jduffy105/HydraMeter_L_DesignReview_0.1.1/PDF_and_Images/PCB_Bottom.PNG

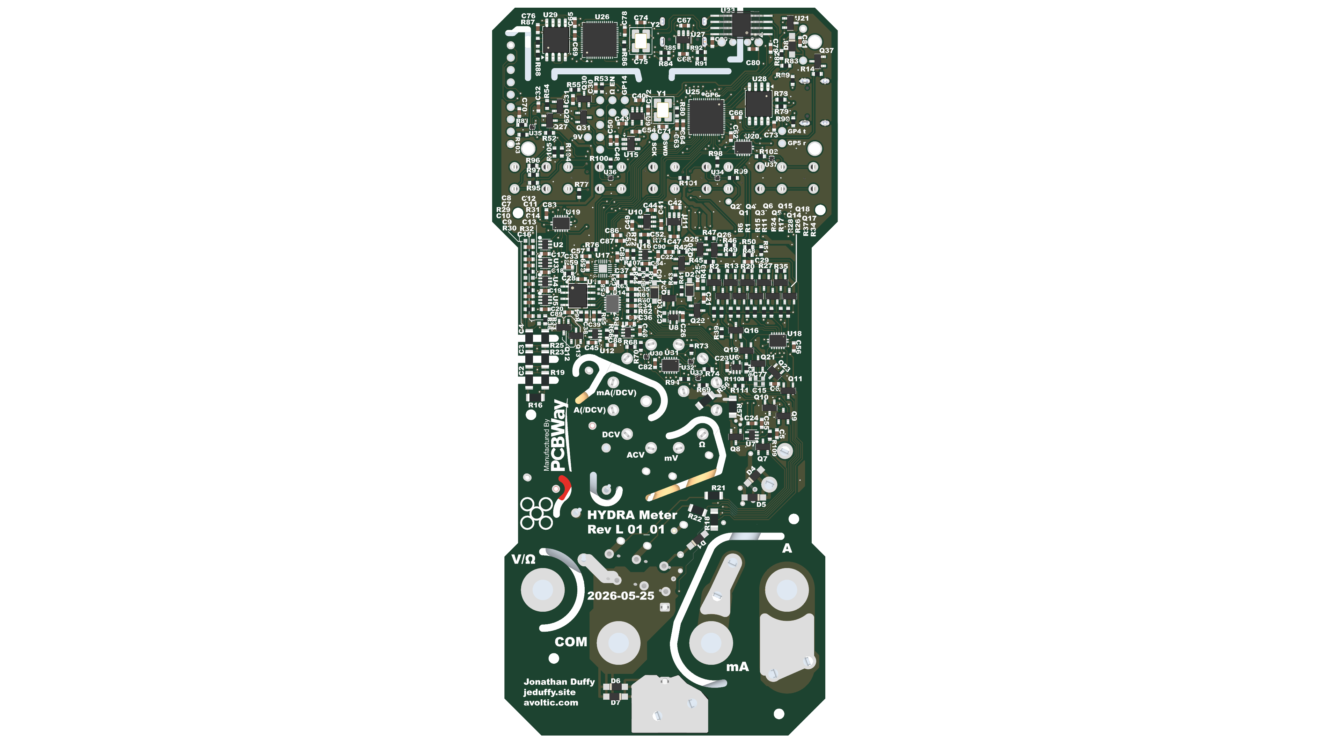
PDF_and_Images/PCB_Bottom.PNG
