jduffy105/HydraMeter_L_DesignReview_0.1.1/Production_Files/2026-05-25-00-31-10/Customer_Update_T-1D27W43482A-12units-LCMTR_0101_BOM_ul_26_05_25_0014.xls

PCBWay Bom Quotation, Product No.:T-1D27W43482A
Item # | *Designator | *Qty | Manufacturer | *Mfg Part # | Description / Value | Vendor Part # | *Package/Footprint | Your Instructions / Notes | *Unit Price(12 units) | *Total | *Delivery Time | *Actual Purchase Mfg Part # | *PCBWay Note | Customer Reply | PCBWay Update
1 | C2,C3,C4 | 3 | muRata | GRM31A5C3A331JWA1D | 330p | Digikey『 』490-GRM31A5C3A331JWA1DCT-ND『 』https://www.digikey.com/en/products/detail/murata-electronics/GRM31A5C3A331JWA1D/10692922 | 1206 |  | $0.171 | $6.156
2 | C5,C14,C43,C44 | 4 | YAGEO | CC0603FRNPO9BN101 | 100p | LCSC『 』C513648『 』https://www.lcsc.com/product-detail/C513648.html | 0603 |  | $0.019 | $0.912
3 | C6,C10,C13,C85,C86,C87,C88,C95 | 8 | YAGEO | CC0603FRNPO9BN102 | 1n | LCSC『 』C309468『 』https://www.lcsc.com/product-detail/C309468.html | 0603 |  | $0.024 | $2.304
4 | C7 | 1 | KEMET | C0603C333J8JACAUTO | 33n | LCSC『 』C3896683『』https://www.lcsc.com/product-detail/C3896683.html | 0603 |  | $0.200 | $2.394 |  |  | The correct capacitance value for the listed Part Number [GRM1887U1A303JA01J] is indeed [30nF], not [33nF].Please confirm. | My mistake - replaced with new part # - C0603C333J8JACAUTO, which should be 33n
5 | C9,C21,C33,C34,C35,C36,C37,C38,C39,C81 | 10 | YAGEO | CC0603JRNPO9BN103 | 10n | LCSC『 』C389113『 』https://www.lcsc.com/product-detail/C389113.html | 0603 |  | $0.032 | $3.840
6 | C11 | 1 | muRata | GRM1885C1H332JA01D | 3.3n | LCSC『 』C77036『 』https://www.lcsc.com/product-detail/C77036.html | 0603 |  | $0.084 | $1.008
7 | C16 | 1 | YAGEO | CC0603JRNPO9BN331 | 330p | LCSC『 』C62784『 』https://www.lcsc.com/product-detail/C62784.html | 0603 |  | $0.048 | $0.576
8 | C17,C18,C19,C20,C23,C24,C25,C45,C46,C52,C53,C55 | 12 | Samsung | CL10B104KB8NNNC | 100n | LCSC『 』C1591『 』https://www.lcsc.com/product-detail/C1591.html | 0603 | Equivalent subsitiutions allowed if approved by customer | $0.007 | $1.008
9 | C22,C26,C28,C29,C30,C31,C32,C40,C41,C42,C47,C48,C49,C50,C51,C54,C56,C57,C58,C59,C60,C62,C63,C64,C65,C66,C67,C68,C69,C70,C73,C76,C78,C79,C80,C82,C83,C84,C89,C90,C91 | 41 | Samsung | CL10B105KB8NQNC | 1u | LCSC『 』C5199872『 』https://www.lcsc.com/product-detail/C5199872.html&spm=wm.fly.bg.9.xh___wm.fly.tp.4.ml | 0603 | Equivalent subsitiutions allowed if approved by customer | $0.011 | $5.412
10 | C71,C72,C74,C75 | 4 | Samsung | CL10C150JB8NNNC | 15p | LCSC『 』CL10C150JB8NNNC『 』https://www.lcsc.com/product-detail/C1644.html | 0603 |  | $0.016 | $0.768
11 | D1,D4,D5,D6,D7,D8 | 6 | SMC | 1N4007FL | 1N4007FL | LCSC『 』C493190『 』https://www.lcsc.com/product-detail/C493190.html | 1N4007FL |  | $0.155 | $11.160 | 7-10 Workdays
12 | D2 | 1 | VISHAY | MMSZ4691-E3-08 | 6.1V | Digikey『 』MMSZ4691-E3-08GICT-ND『 』https://www.digikey.com/en/products/detail/vishay-general-semiconductor-diodes-division/MMSZ4691-E3-08/4832264 | SOD123_MMSZ5231B-7-F |  | $0.509 | $6.108 | 7-10 Workdays
13 | D3 | 1 | Diodes Inc | MMSZ5232B-7-F | 5.6V | LCSC『 』C156265『 』https://www.lcsc.com/product-detail/C156265.html | SOD123_MMSZ5231B-7-F |  | $0.047 | $0.564
14 | Q1,Q3,Q5,Q7,Q8,Q9,Q10,Q12,Q13,Q14,Q17,Q20,Q26,Q30,Q37 | 15 | onsemi | MMBT3904LT1G |  | LCSC『 』C81464『 』https://www.lcsc.com/product-detail/C81464.html | SOT23-3 |  | $0.021 | $3.780
15 | Q2,Q4,Q6,Q11,Q15,Q18,Q22,Q24,Q25,Q27,Q29,Q31 | 12 | Diotec | MMFTP84 |  | Digikey『 』4878-MMFTP84CT-ND『 』https://www.digikey.com/en/products/detail/diotec-semiconductor/MMFTP84/13154778 | DMN65D8L-7 |  | $0.129 | $18.576 | 7-10 Workdays
16 | Q16,Q19,Q21,Q23 | 4 | Infineon | IRLML6344TRPBF |  | LCSC『 』C53550『 』https://www.lcsc.com/product-detail/C53550.html | DMN65D8L-7 |  | $0.189 | $9.072
17 | R1,R11,R17,R26,R34,R39,R45,R49,R50,R52,R53,R71,R72,R95,R96,R97 | 16 | YAGEO | RC0603FR-07100KL | 100K | LCSC『 』C14675『 』https://www.lcsc.com/product-detail/C14675.html | 0603 | Equivalent subsitiutions allowed if approved by customer | $0.002 | $0.384
18 | R2,R13,R20,R27,R35,R36,R47,R54,R68,R69,R70,R73,R74 | 13 | YAGEO | RT0603FRE07330KL | 330K | LCSC『 』C863745『 』https://www.lcsc.com/product-detail/C863745.html | 0603 | Equivalent subsitiutions allowed if approved by customer | $0.023 | $3.588
19 | R14,R33,R42,R55,R80,R83,R86,R88,R109,R110,R111 | 11 | YAGEO | RC0603FR-071KL | 1K | LCSC『 』C22548『 』https://www.lcsc.com/product-detail/C22548.html | 0603 | Equivalent subsitiutions allowed if approved by customer | $0.003 | $0.396
20 | R16 | 1 | Bourns | CHV1206-FX-1003ELF | 100K | LCSC『 』C2078737『 』https://www.lcsc.com/product-detail/C2078737.html | 1206 |  | $0.364 | $4.368
21 | R18 | 1 | YAGEO | SR1206JR-7W470RL |  | LCSC『 』C874087『 』https://www.lcsc.com/product-detail/C874087.html | 1206 |  | $0.089 | $1.068
22 | R21,R22 | 2 | YAGEO | AH1206FR-071ML | 1M | LCSC『 』C43749042『 』https://www.lcsc.com/product-detail/C43749042.html | 1206 |  | $0.092 | $2.208
23 | R41,R48,R66,R67,R76,R77,R82,R87 | 8 | YAGEO | RC0603FR-0710KL | 10K | LCSC『 』C98220『 』https://www.lcsc.com/product-detail/C98220.html | 0603 | Equivalent subsitiutions allowed if approved by customer | $0.002 | $0.192
24 | R43,R44 | 2 | Vishay | MCT06030D3301BP500 | 3.3K | LCSC『 』C1700477『 』https://www.lcsc.com/product-detail/C1700477.html | 0603 |  | $0.240 | $5.760
25 | R46,R51,R94,R98,R99,R100,R101,R102 | 8 | Vishay | CRCW060333K0FKEA | 33K | LCSC『 』C844778『 』https://www.lcsc.com/product-detail/C844778.html | 0603 | Equivalent subsitiutions allowed if approved by customer | $0.011 | $1.056
26 | R59,R60,R61,R62,R63,R64,R65,R106,R107 | 9 | Panasonic | ERJ3EKF2200V |  | LCSC『 』C403073『 』https://www.lcsc.com/product-detail/C403073.html | 0603 | Equivalent subsitiutions allowed if approved by customer | $0.013 | $1.404
27 | R75,R78,R79,R81,R84,R85,R103,R104,R105 | 9 | Vishay | CRCW060327R0FKEA |  | LCSC『 』C844545『 』https://www.lcsc.com/product-detail/C844545.html | 0603 |  | $0.014 | $1.512
28 | R89,R90,R91,R92 | 4 | YAGEO | AC0603FR-075K1L | 5.1K | LCSC『 』C125891『 』https://www.lcsc.com/product-detail/C125891.html | 0603 | Equivalent subsitiutions allowed if approved by customer | $0.007 | $0.336
29 | U1 | 1 | Diodes Inc | AS2376QS-13 | 0.2pA 5uV | LCSC『 』C19948478『 』https://www.lcsc.com/product-detail/C19948478.html | SOIC-8_AS2376S-13 |  | $0.673 | $8.076 | 7-10 Workdays
30 | U2,U3,U4,U5 | 4 | Texas Instruments | TS5A3159DCKR | TS5A3159DCKR | LCSC『 』C46388『 』https://www.lcsc.com/product-detail/C46388.html | SC-70_TS5A3159DCKR |  | $0.289 | $13.872
31 | U6,U7,U8,U12,U13,U16 | 6 | Texas Instruments | TLV333IDCKR | TLV333IDCKR | LCSC『 』C181502『 』https://www.lcsc.com/product-detail/C181502.html | SC-70-5_AS333SE-7 |  | $0.280 | $20.160
32 | U9,U10 | 2 | Diodes Inc | AP2210K-5.0TRG1 | 5V | LCSC『 』C500758『 』https://www.lcsc.com/product-detail/C500758.html | SOT23-5 |  | $0.218 | $5.232
33 | U11,U15,U27 | 3 | Toshiba | TCR2EF33,LM(CT | 3.3V | LCSC『 』C843273『 』https://www.lcsc.com/product-detail/C843273.html | SC-74A_standard |  | $0.106 | $3.816
34 | U14 | 1 | Nexperia | NMUX1308BQX | NMUX1308 | Digikey『 』1727-NMUX1308BQXCT-ND『 』https://www.digikey.com/en/products/detail/nexperia-usa-inc/NMUX1308BQX/22050149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 | 16-DHVQFN_NMUX1308 |  | $0.382 | $4.584 | 7-10 Workdays
35 | U17 | 1 | Microchip | MCP3561RT-E/NC | MCP3561RT | Digikey『 』150-MCP3561RT-E/NCCT-ND『 』https://www.digikey.com/en/products/detail/microchip-technology/MCP3561RT-E-NC/12807389 | MCP3460R_VQFN-20_3x3mm_EP |  | $4.689 | $56.268 | 7-10 Workdays
36 | U18,U19,U20,U31 | 4 | Nexperia | 74HC595BQ,115 | 74HC595BQ,115 | LCSC『 』C730243『 』https://www.lcsc.com/product-detail/C730243.html | 16-DHVQFN_74HC595BQ |  | $0.262 | $12.576
37 | U21 | 1 | Microchip | 11AA160T-I/TT | 16Kbit | Digikey『 』11AA160T-I/TTCT-ND『 』https://www.digikey.com/en/products/detail/microchip-technology/11AA160T-I-TT/1851330 | SOT23-3 |  | $0.613 | $7.356 | 7-10 Workdays
38 | U23 | 1 | Texas Instruments | ISO6721FQDWVRQ1 | ISO6721FQDWVRQ1 | LCSC『 』C5216428『 』https://www.lcsc.com/product-detail/C5216428.html | SOIC-8_STISO621TR |  | $1.090 | $13.080
39 | U25,U26 | 2 | Raspberry Pi | RP2040 | RP2040 | LCSC『 』C2040『 』https://www.lcsc.com/product-detail/C2040.html | QFN-56-1EP_7x7mm_P0.4mm_EP3.2x3.2mm |  | $1.308 | $31.392
40 | U28,U29 | 2 | Winbond | W25Q16JVSS | W25Q16JVSS | LCSC『 』C82317『 』https://www.lcsc.com/product-detail/C82317.html | SOIC-8_5.3x5.3mm_P1.27mm |  | $0.981 | $23.544 |  | W25Q16JVSSIQ |  | Customer Accepts
41 | U30,U32,U33,U34,U35,U36,U37 | 7 | onsemi | NST3904DP6T5G | NST3904DP6T5G | LCSC『 』C462939『 』https://www.lcsc.com/product-detail/C462939.html | SOT-963_NST3904DP6T5G |  | $0.065 | $5.460
42 | Y1,Y2 | 2 | Abracon | ABM8-272-T3 | ABM8-272-T3 | LCSC『 』C20625731『 』https://www.lcsc.com/product-detail/C20625731.html | XTAL_3225-4Pin_3.2x2.5mm |  | $0.480 | $11.520
 |  |  |  |  |  |  |  |  | Component Cost | $312.85
 |  |  |  |  |  |  |  |  | Assembly Cost
 |  |  |  |  |  |  |  |  | PCB Cost
 |  |  |  |  |  |  |  |  | V2 Member 2% off | -$0.00
 |  |  |  |  |  |  |  |  | All Total 12 Units | $312.85
