jduffy105/HydraMeter_L_DesignReview_0.1.1/PDF_and_Images/LCMTR_01_01-User_Comments.pdf

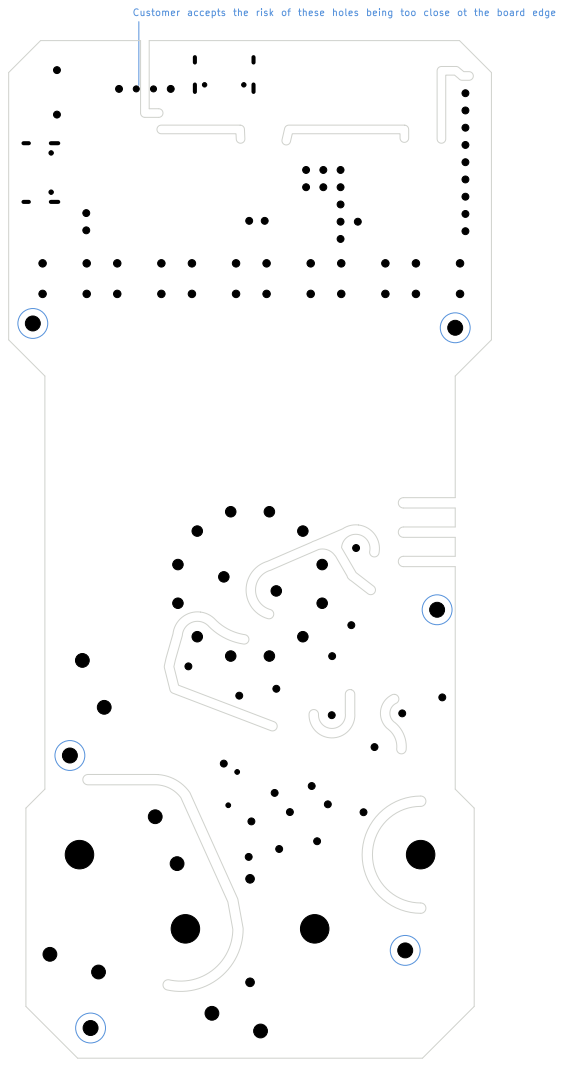
[picture p2: page 1]

Customer accepts the risk of these holes being too close ot the board edge
