jduffy105/HydraMeter_L_DesignReview_0.1.1/PDF_and_Images/sch.pdf

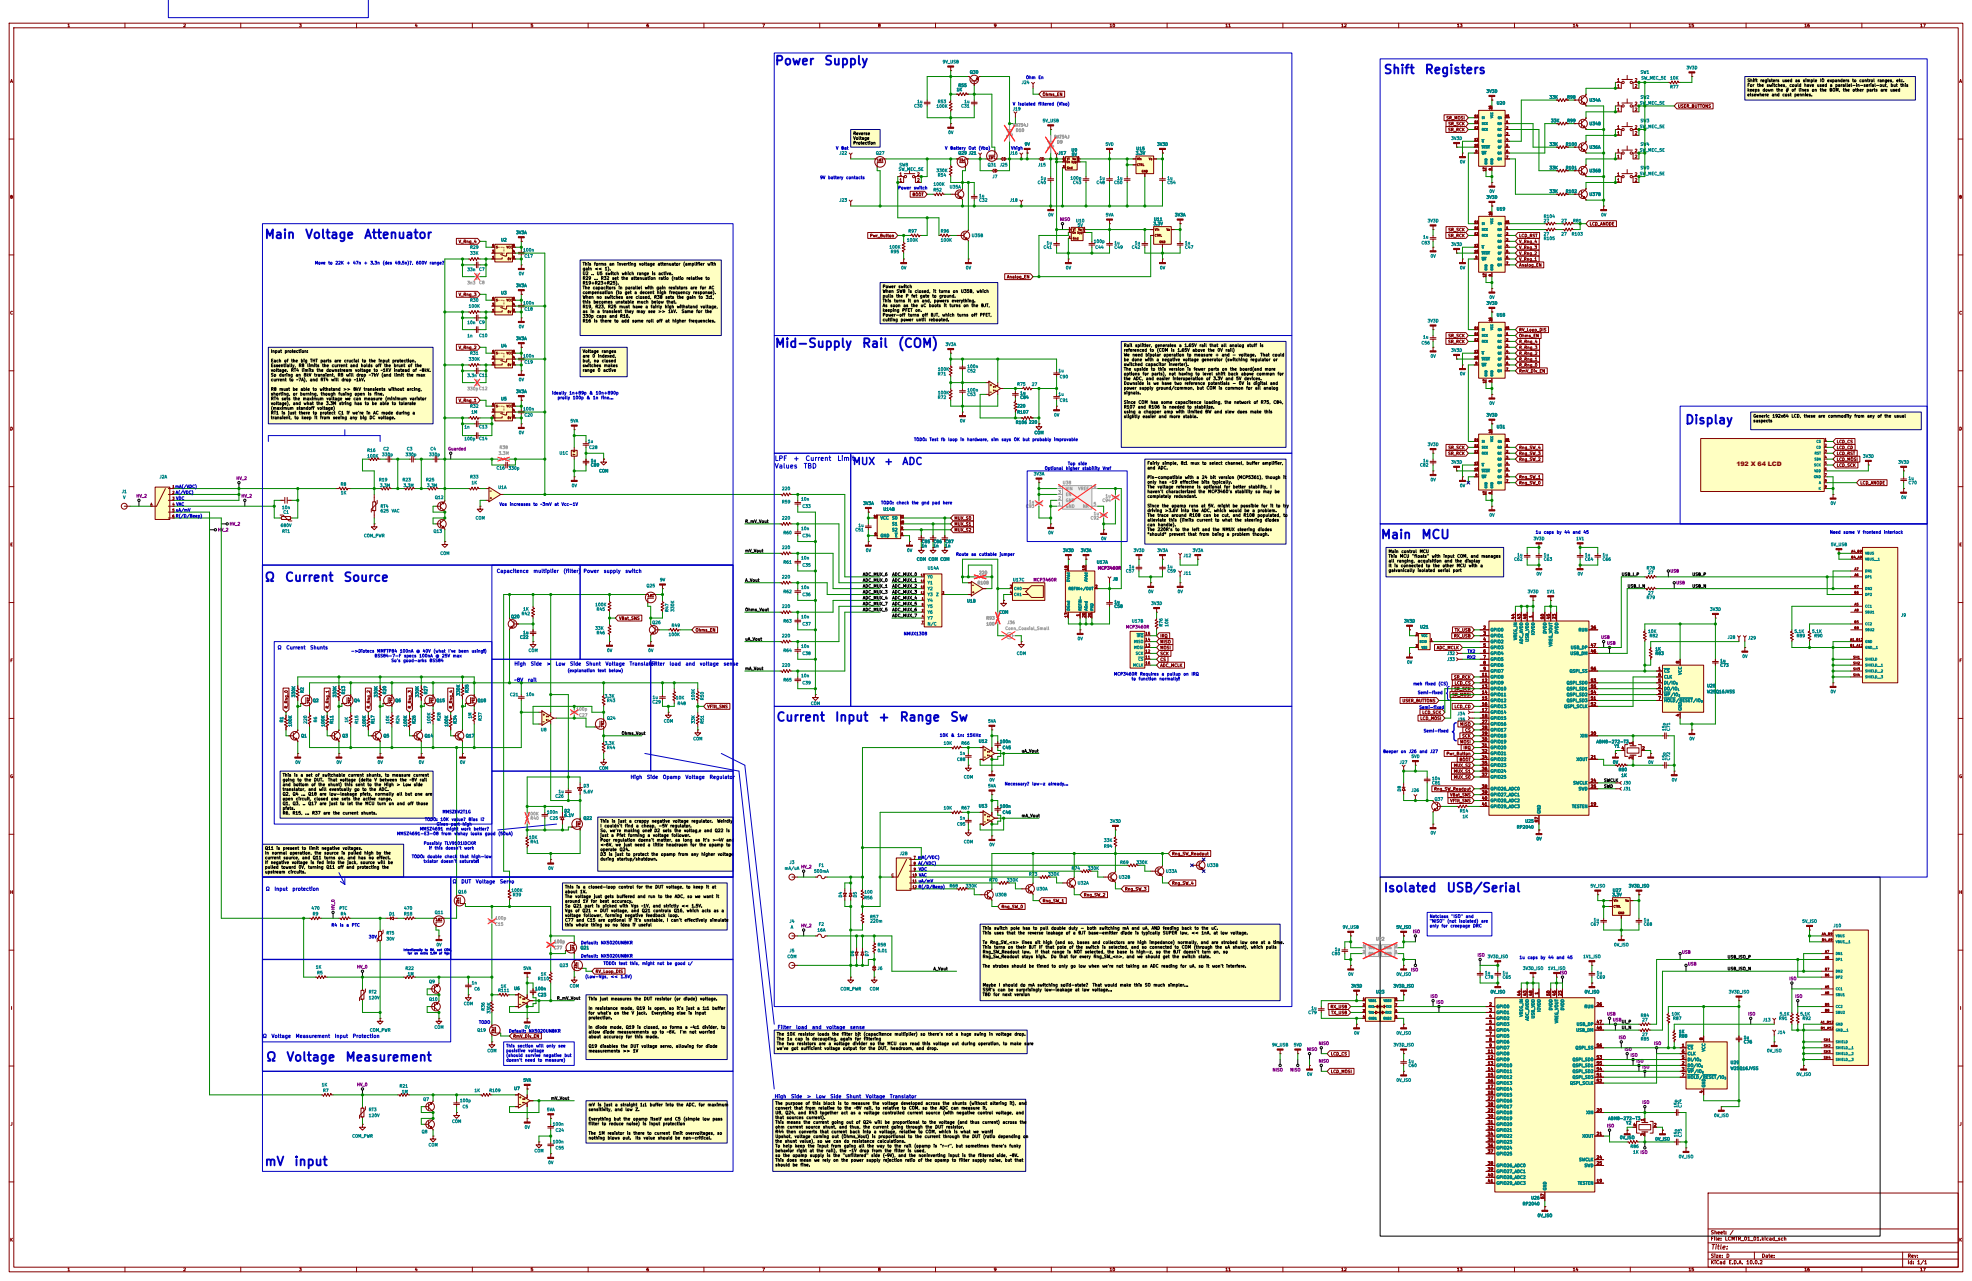
[picture p3: page 1]

V isolated filtered (Viso) 9V battery contacts Power Supply

Need some V frontend interlock Shift Registers

Shift registers used as simple IO expanders to control ranges, etc. For the switches, could have used a parallel-in-serial-out, but this

keeps down the # of lines on the BOM, the other parts are used

elsewhere and cost pennies. Rail splitter, generates a 1.65V rail that all analog stuff is

Generic 192x64 LCD, these are commodity from any of the usual suspects Move to 22K + 47n + 3.3n (des 49.5n)?, 600V range?

This forms an inverting voltage attenuator (amplifier with
gain << 1). U2 .. U5 switch which range is active. R29 ... R32 set the attenuation ratio (ratio relative to R19+R23+R25). The capacitors in parallel with gain resistors are for AC

VAC Mid-Supply Rail (COM)

compensation (to get a decent high frequency response). When no switches are closed, R38 sets the gain to 3:1, this becomes unstable much below that. R19, R23, R25 must have a fairly high withstand voltage, as in a transient they may see >> 1kV. Same for the 330p caps and R16. R16 is there to add some roll off at higher frequencies.

pulls the P fet gate to ground. This turns it on and, powers everything. As soon as the uC boots it turns on the BJT,

keeping PFET on. Power-off turns off BJT, which turns off PFET,

cutting power until rebooted.

Input protection: Each of the big THT parts are crucial to the input protection.

Voltage ranges are 0 indexed,

referenced to (COM is 1.65V above the 0V rail) We need bipolar operation to measure + and - voltage. That could

be done with a negative voltage generator (switching regulator or switched capacitor inverter). The upside to this version is fewer parts on the board(and more options for parts), not having to level shift back above common for

Essentially, R8 limits the current and holds off the brunt of the
voltage. RT4 limits the downstream voltage to ~1KV instead of ~8kV. So during an 8kV transient, R8 will drop ~7kV (and limit the max current to ~7A), and RT4 will drop ~1kV. R8 must be able to withstand >> 8kV transients without arcing,

TODO: Test fb loop in hardware, sim says OK but probably improvable Route as cuttable jumper 10K & 1n: 15KHz uA/mV

the ADC, and easier interoperation of 3.3V and 5V devices. Downside is we have two reference potentials - 0V is digital and

power supply ground/common, but COM is common for all analog
signals. Since COM has some capacitence loading, the network of R75, C84, R107 and R106 is needed to stabilize. using a chopper amp with limited BW and slew does make this

shorting, or burning, though fusing open is fine. RT4 sets the maximum voltage we can measure (minimum varistor voltage), and what the 3.3M string has to be able to tolerate

(maximum standoff voltage) RT1 is just there to protect C1 if we're in AC mode during a

slightly easier and more stable.

transient, to keep it from seeing any big DC voltage.

Top side Optional higher stability Vref

Fairly simple, 8:1 mux to select channel, buffer amplifier, and ADC. Pin-compatible with a 24 bit version (MCP5361), though it only has ~19 effective bits typically. The voltage referene is optional for better stability, I haven't characterized the MCP3460's stability so may be

completely redundant. Since the opamp runs at 5V, might be possible for it to try

TODO: check the gnd pad here
11 VCC

driving >3.6V into the ADC, which would be a problem. The trace around R108 can be cut, and R108 populated, to

alleviate this (limits current to what the steering diodes can handle). The 220R's to the left and the NMUX steering diodes

*should* prevent that from being a problem though.

This MCU "floats" with input COM, and manages all ranging, acquisition and the display

1 REFIN+/OUT 2 DGnd 17 DVdd 18 AVdd 19 AGnd 20 PAD 21 U17A MCP3460R

1 REFIN+/OUT 2 DGnd 17 DVdd 18 AVdd 19 AGnd 20 PAD 21

It is connected to the other MCU with a
galvanically isolated serial port

Power supply switch Ω Current Source

Filter load and voltage sense

Current Input + Range Sw

Semi-fixed meh fixed (CS) Semi-fixed

Beeper on J26 and J27 High Side > Low Side Shunt Voltage Translator

This is a set of switchable current shunts, to measure current going to the DUT. That voltage (delta V between the ~8V rail and bottom of the shunt) this sent to the High > Low side

translator, and will eventually go to the ADC. Q2, Q4 ... Q18 are low-leakage pfets, normally all but one are open circuit, closed one sets the active range. Q1, Q3, .. Q17 are just to let the MCU turn on and off those pfets.

R6, R15, ... R37 are the current shunts. Q11 is present to limit negative voltages.

This is just a crappy negative voltage regulator. Weirdly
I couldn't find a cheap, -5V regulator.
So, we're making one! D2 sets the voltag,e and Q22 is
just a Pfet forming a voltage follower. Poor regulation doens't matter, as long as it's >~4V and <~6V, we just need a little headroom for the opamp to

Possibly TLV9101IDCKR
if this doesn't work

In normal operation, the source is pulled high by the
current source, and Q11 turns on, and has no effect.
If negative voltage is fed into the jack, source will be pulled toward 0V, turning Q11 off and protecting the upstream circuits.

operate Q24. D3 is just to protect the opamp from any higher voltage

10 | R73 | 330K

This is a closed-loop control for the DUT voltage, to keep it at about 1V. The voltage just gets buffered and run to the ADC, so we want it around 1V for best accuracy. So Q21 part is picked with Vgs ~1V, and strictly << 1.5V. Vgs of Q21 = DUT voltage, and Q21 controls Q16, which acts as a

1u caps by 44 and 45 Isolated USB/Serial

voltage follower, forming negative feedback loop. C77 and C15 are optional if it's unstable, I can't effectively simulate

"NISO" (not isolated) are only for creepage DRC

Intentionally to 0V, not COM,

Rng_SW_Readout low. If that range is NOT selected, the base is high-z, so the BJT doesn't turn on, so Rng_Sw_Readout stays high. Do that for every Rng_SW_<n>, and we should get the switch state. The strobes should be timed to only go low when we're not taking an ADC reading for uA, so it won't interfere. Maybe I should do mA switching solid-state? That would make this SO much simpler... SSR's can be surprisingly low-leakage at low voltage... TBD for next version

TODO: test this, might not be good :/
RV_Loop_DIS

This just measures the DUT resistor (or diode) voltage.

In resistance mode, Q19 is open, so it's just a 1:1 buffer
for what's on the V jack. Everything else is input
protection.

In diode mode, Q19 is closed, so forms a ~4:1 divider, to
allow diode measurements up to ~6V. I'm not worried
about accuracy for this mode. Q19 disables the DUT voltage servo, allowing for diode measurements >> 1V

Ω Voltage Measurement Input Protection
Ω Voltage Measurement

The 10K resistor loads the filter bjt (capacitence multiplier) so there's not a huge swing in voltage drop. The 1u cap is decoupling, again for filtering

The two resistors are a voltage divider so the MCU can read this voltage out during operation, to make sure we've got sufficient voltage output for the DUT, headroom, and drop.

This section will only see posistive voltage

The purpose of this block is to measure the voltage developed across the shunts (without altering it), and
convert that from relative to the ~8V rail, to relative to COM, so the ADC can measure it. U8, Q24, and R43 together act as a voltage controlled current source (with negative control voltage, and

mV is just a straight 1:1 buffer into the ADC, for maximum
sensitivity, and low Z. Everything but the opamp itself and C5 (simple low pass

filter to reduce noise) is input protection

that sources current). This means the current going out of Q24 will be proportional to the voltage (and thus current) across the ohm current source shunt, and thus, the current going through the DUT resistor. R44 then converts that current back into a voltage, relative to COM, which is what we want! Upshot, voltage coming out (Ohms_Vout) is proportional to the current through the DUT (ratio depending on

The 1M resistor is there to current limit overvoltages, so
nothing blows out. Its value should be non-critical.

the shunt value), so we can do resistance calculations. To help keep the input from going all the way to the rail (opamp is "r-r", but sometimes there's funky behavior right at the rail), the ~1V drop from the filter is used, so the opamp supply is the "unfiltered" side (~9V), and the noninverting input is the filtered side, ~8V. This does mean we rely on the power supply rejection ratio of the opamp to filter supply noise, but that should be fine.

Size: D | Rev:
KiCad E.D.A. 10.0.2 | Id: 1/1
