jduffy105/HydraMeter_L_DesignReview_0.1.1/PDF_and_Images/LCMTR_01_01-B_Cu.pdf

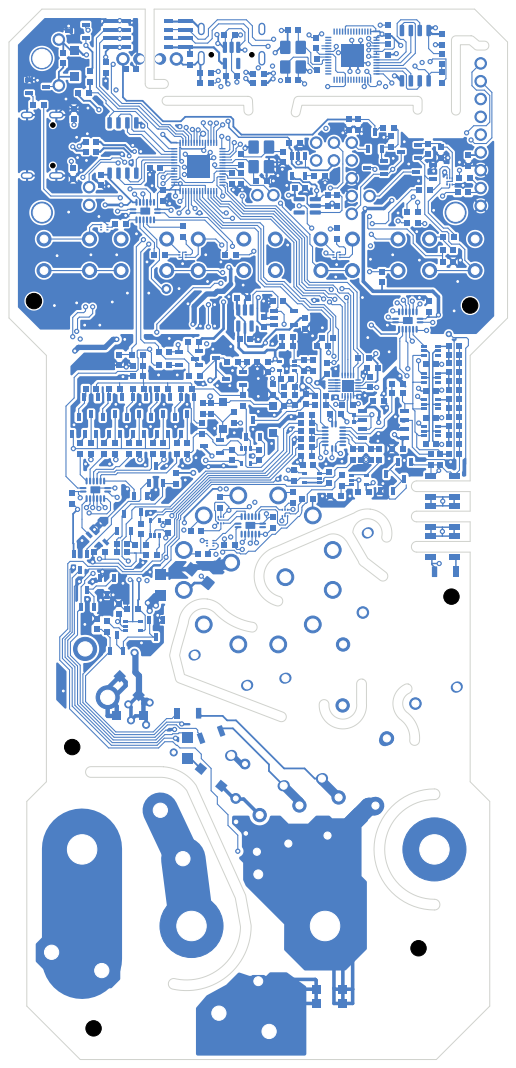
[picture p4: page 1]
