jduffy105/HydraMeter_L_DesignReview_0.1.1/PDF_and_Images/LCMTR_01_01-F_Cu.pdf

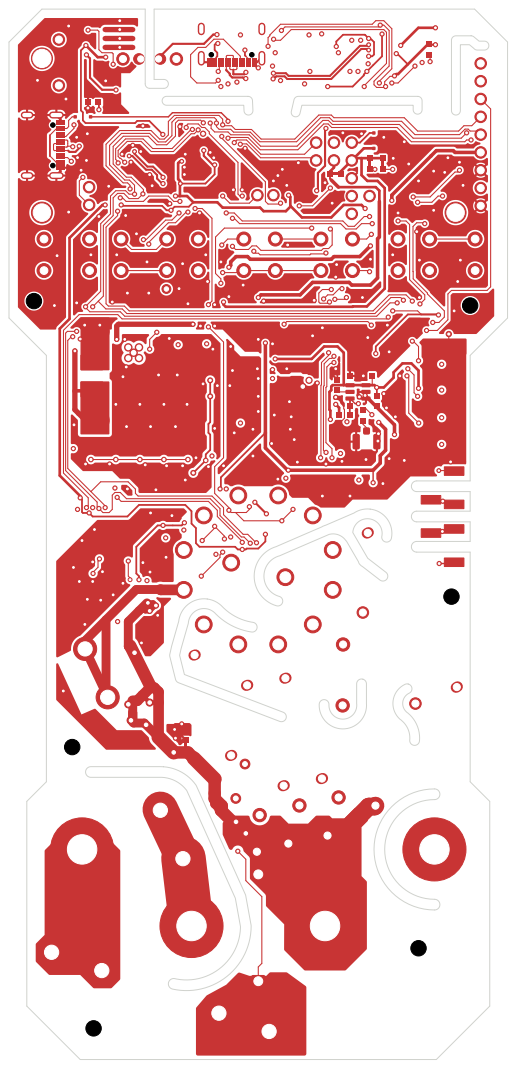
[picture p5: page 1]
