jduffy105/HydraMeter_L_DesignReview_0.1.1/PDF_and_Images/LCMTR_01_01-In1_Cu.pdf

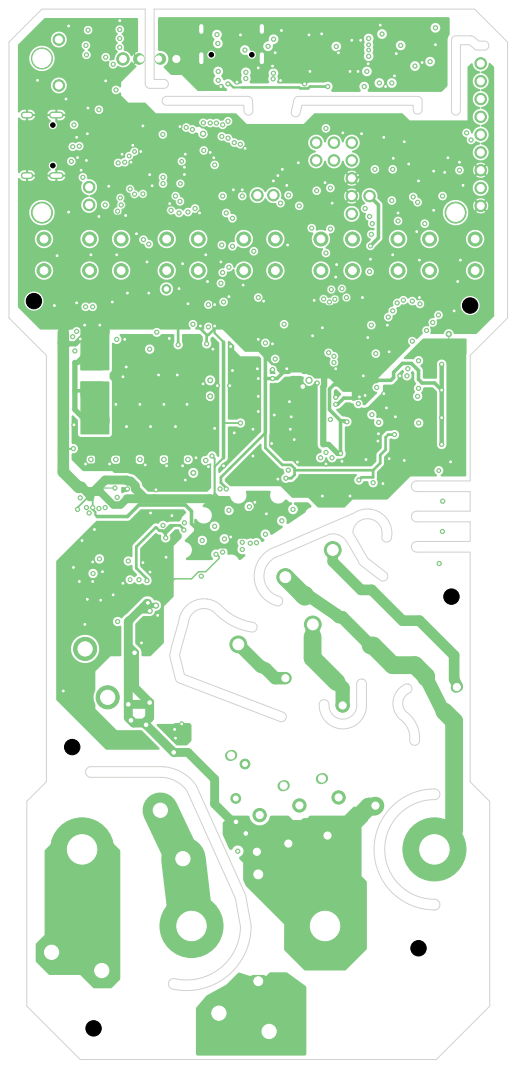
[picture p6: page 1]
