jduffy105/HydraMeter_L_DesignReview_0.1.1/PDF_and_Images/LCMTR_01_01-In2_Cu.pdf

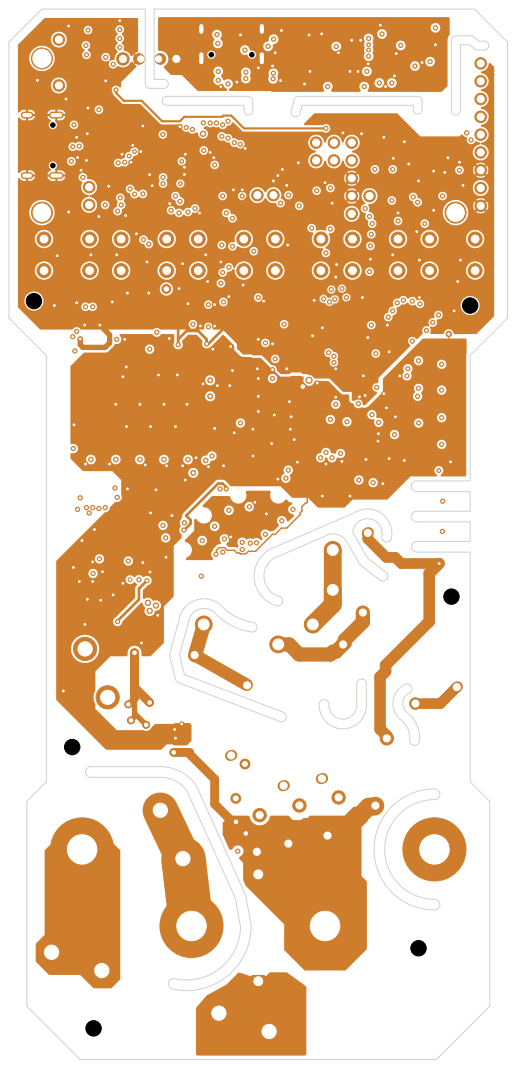
[picture p7: page 1]
