jduffy105/HydraMeter_L_DesignReview_0.1.1/PDF_and_Images/LCMTR_01_01-User_2.pdf

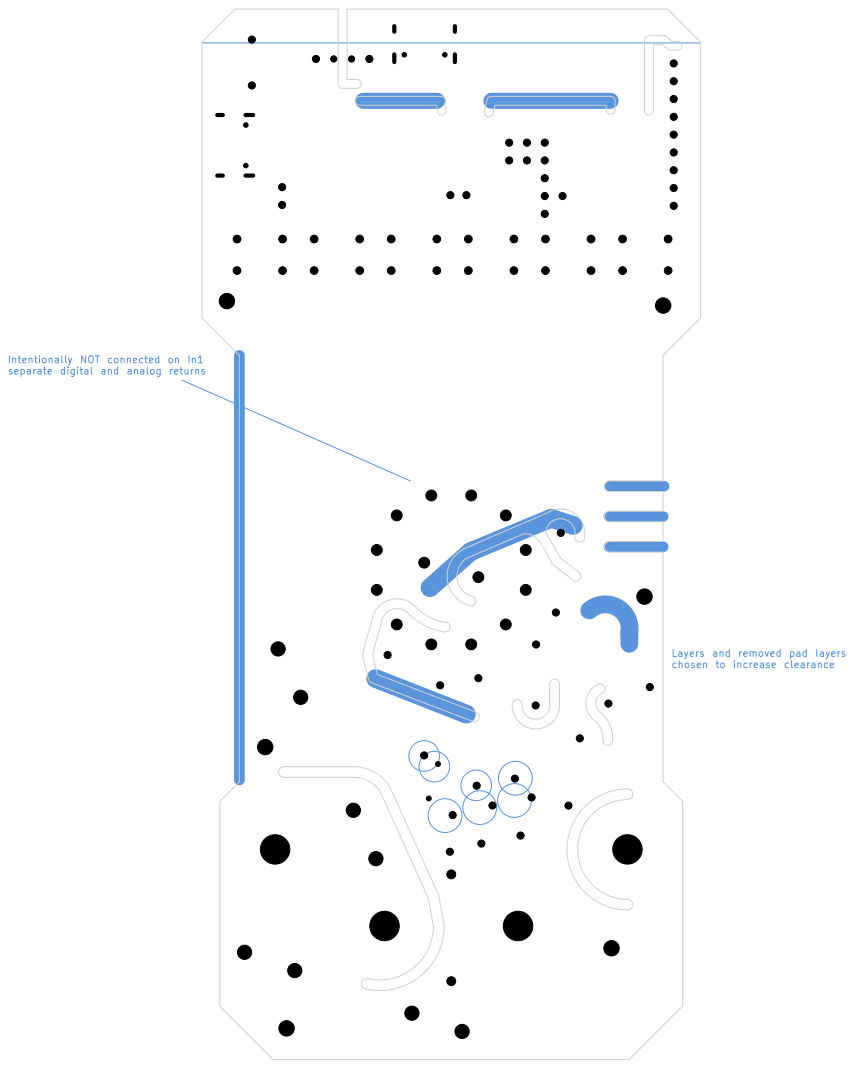
[picture p8: page 1]

Intentionally NOT connected on In1
separate digital and analog returns

Layers and removed pad layers chosen to increase clearance
