jduffy105/HydraMeter_L_DesignReview_0.1.1/PDF_and_Images/LCMTR_01_01-User_Drawings.pdf

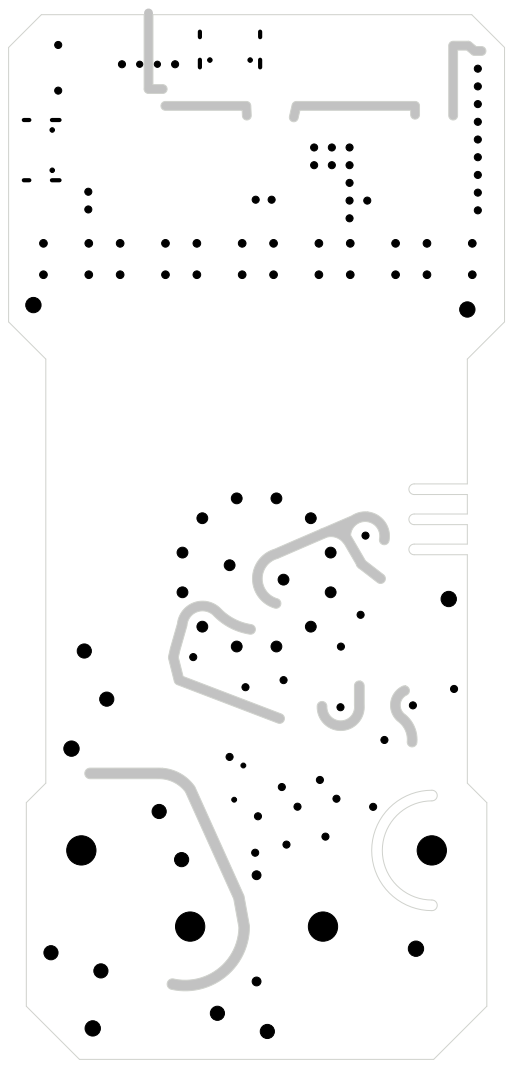
[picture p9: page 1]
