jduffy105/HydraMeter_L_DesignReview_0.1.1/(commit log)

2026-05-16 Generated outputs, copied to repo 26/5/15 19:34
    [LCMTR_BOM_01.ods]
2026-05-26 Updated to 26_05_25 and added production files
    Contains all updates since DR, and production files.
    Board should be complete, schematic still needs a little clean up but connections and parts should be done.
    [Customer_Update_T-1D27W43482A-12units-LCMTR_0101_BOM_ul_26_05_25_0014.xls, LCMTR_0101_BOM_ul_26_05_25_0014.xlsx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]
